PerAsperaAdAstra-Liu/stm32-bionic-dog/Docs/reset_pose.png

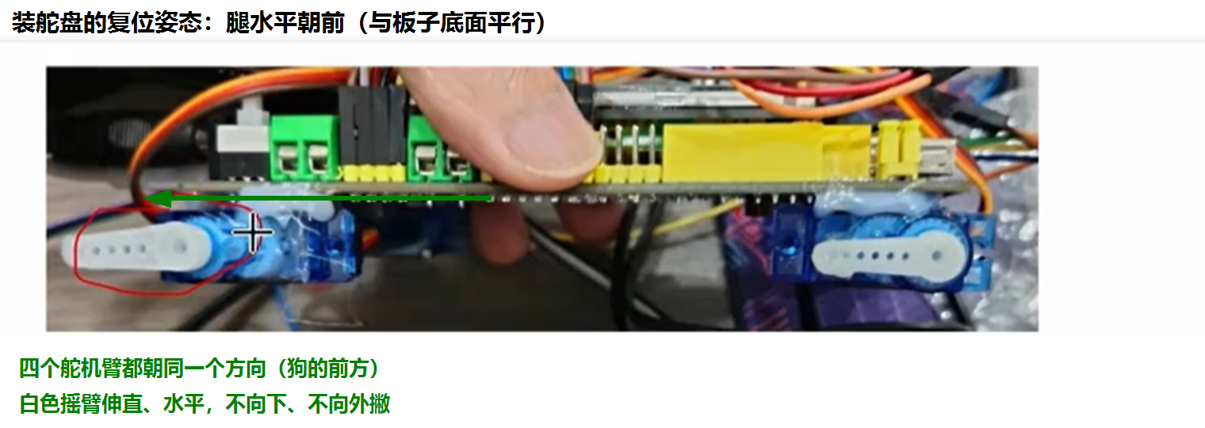
Docs/reset_pose.png
