PerAsperaAdAstra-Liu/stm32-bionic-dog/Docs/课程设计提交说明.md

# 旺财一号课程设计提交包说明

## 项目信息

- 学院：机电工程与自动化
- 项目成员：本人、同学 A
- 指导教师：杨庆华

## 提交内容

1. `01_课程设计报告`：课程设计报告，已补充答辩反馈中的交互化升级方案。
2. `02_答辩材料`：含演示视频的答辩 PPT，以及详细答辩讲稿。
3. `03_演示视频`：从 PPT 中提取的独立 MP4 文件，便于单独播放和归档。
4. `04_软件与固件`：Keil 工程源码、编译生成的 HEX 文件、SU-03T 固件和配置清单。
5. `05_硬件资料`：接线表、引脚分配、电源与机械安装说明、OLED 表情资源和系统框图。

## 系统概述

系统以 STM32F407ZGT6 为主控，SU-03T 完成离线语音识别，USART6 接收命令字节。TIM4 输出四路 20 ms PWM 驱动四个 SG90 舵机，OLED 通过软件 I2C 显示表情，三盏板载 LED 提供灯光反馈。

## 编译与下载

- 开发环境：Keil MDK 5.43a，Arm Compiler 6.24
- 下载器：ST-Link
- 目标器件：STM32F407ZGT6
- 编译结果：0 Error，0 Warning
- 只读占用：约 15.6 KB

打开 `04_软件与固件/Dog_V1/Project/Dog.uvprojx`，确认 Debug 页选择 `ST-Link Debugger`，Port 为 SWD，然后执行编译和下载。

## 操作说明

1. 唤醒词：旺财一号、你好旺财。
2. 基础指令：起立、趴下、坐下、前进、后退、开灯、关灯。
3. 动态表情快捷演示：说“开灯”启动吼叫动图，说“关灯”停止并恢复平静。
4. 8、9 号表情分支可用串口助手发送 `08`、`09` 测试。

## 说明

报告第 6.3 节“交互化升级方案”属于后续设计，尚未集成到当前样机，也没有作为实测结果写入测试章节。当前样机实际完成的是语音识别、四足动作、静态与动态表情、灯光反馈以及分阶段调试。
