PerAsperaAdAstra-Liu/stm32-bionic-dog/Docs/fig_face_preview.png

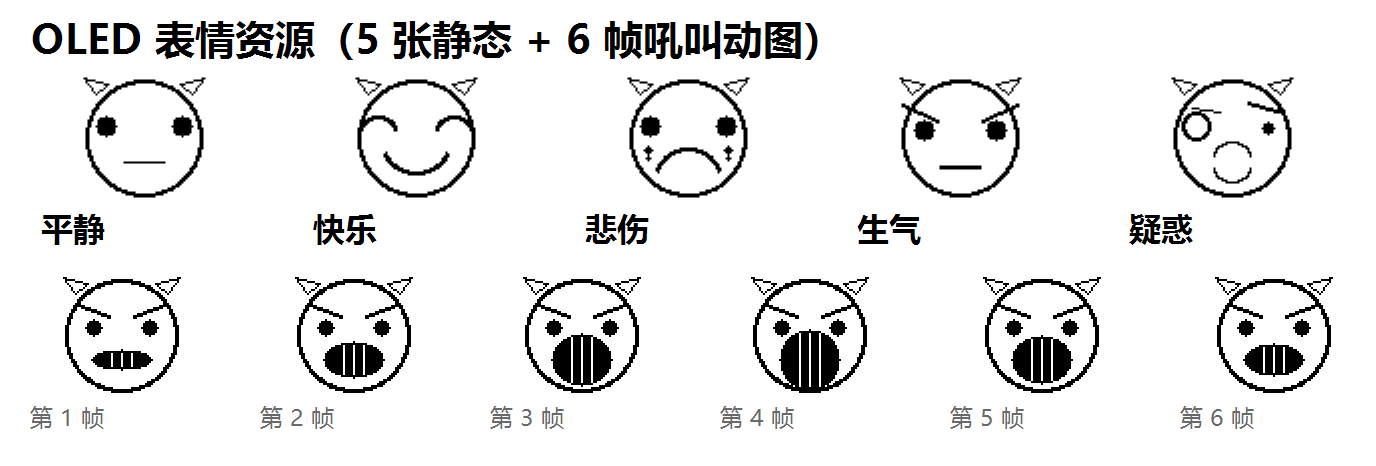
Docs/fig_face_preview.png
