PerAsperaAdAstra-Liu/stm32-bionic-dog/Docs/fig_system_block.png

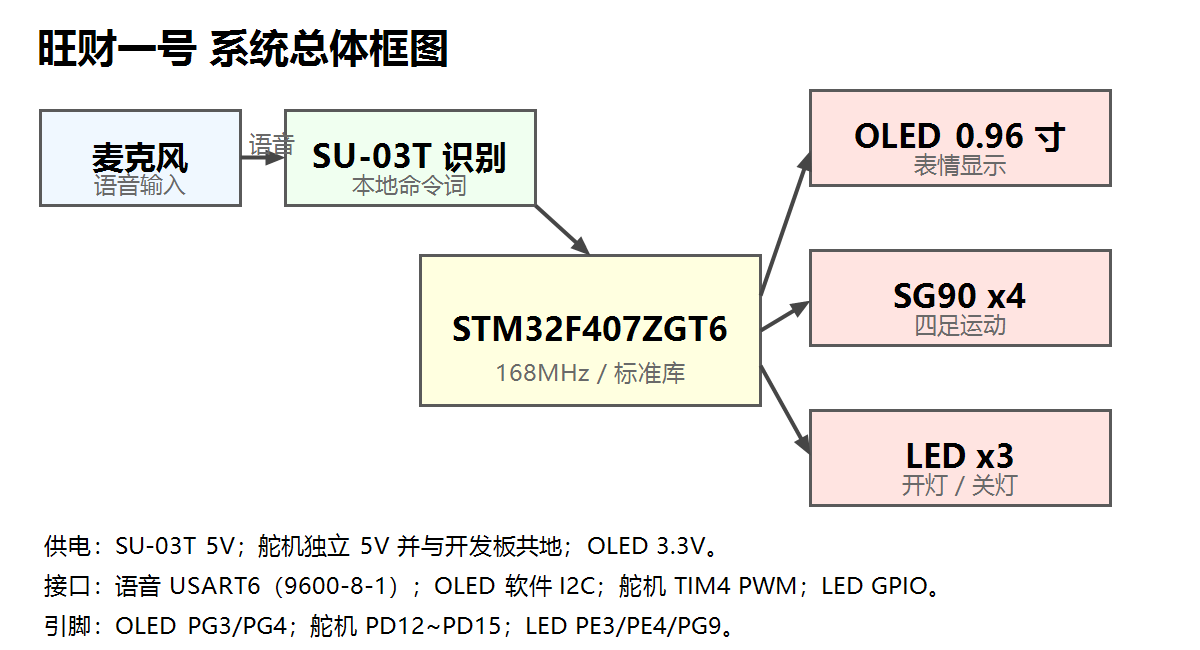
Docs/fig_system_block.png
