PerAsperaAdAstra-Liu/stm32-bionic-dog/Docs/power_bus.png

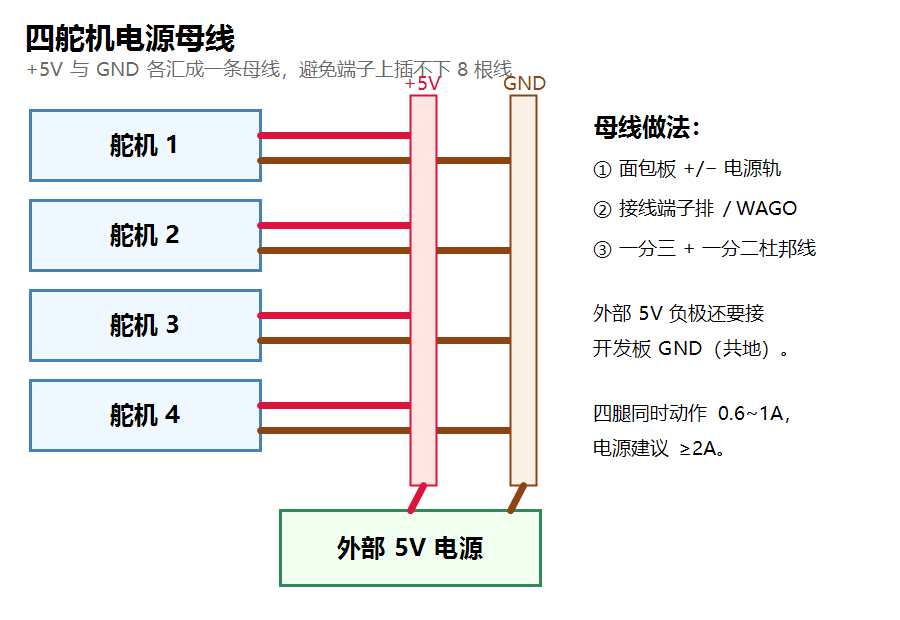
Docs/power_bus.png
