PerAsperaAdAstra-Liu/stm32-bionic-dog/Docs/servo_wiring.png

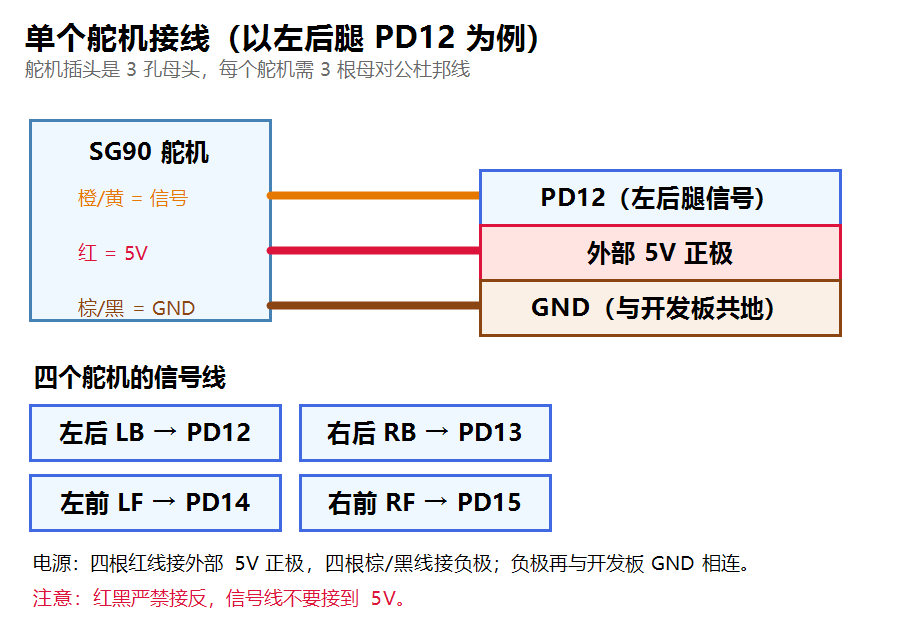
Docs/servo_wiring.png
