PerAsperaAdAstra-Liu/stm32-bionic-dog/(commit log)

2026-11-07 初始化：仿生机器狗旺财一号 STM32F407 课程设计固件
    - 自研模块：LED / SERVO(TIM4 PWM) / USART6(语音) / OLED(软件I2C) 驱动与主框架
    - 含 STM32F4 标准外设库、CMSIS 与启动文件，Keil AC6 可直接编译
    - 完整 Docs 文档与 README，明确已编译与待实测边界
2026-11-07 修复：安全默认值、许可证、隐私与文档一致性
    - DEBUG_MODE 默认改 1（自检模式），避免未标定舵机扫齿
    - 新增 MIT LICENSE 与 THIRD_PARTY_NOTICES（ST MCD-ST V2、ARM Apache-2.0）
    - 课程设计提交说明移除真实姓名学号
    - README 修正宏名 OLED_I2C_SPEED / SPEED_GAIT、脉宽限幅 60~240、生成脚本与 OBJ/LIST 说明
    - servo.h 注释同步限幅范围
    [main.h, servo.h]
